yorickvP/fancontroller/hw/README.md

# Hardware revisions

## Rev 1 (10-2022)
Initial prototype production series, with several issues:
* L302 has an unusable footprint, replace with Farnell 2434098 2.5uH
* 12V is 2.5V
    * R305 -> LCSC code is for 1K
    * 16K & 1K8
* Temperature sensor is placed right next to ESP32
* Would like to toggle vfan rails individually
