yorickvP/fancontroller/hw/1/doc/powersupply-fan.pdf

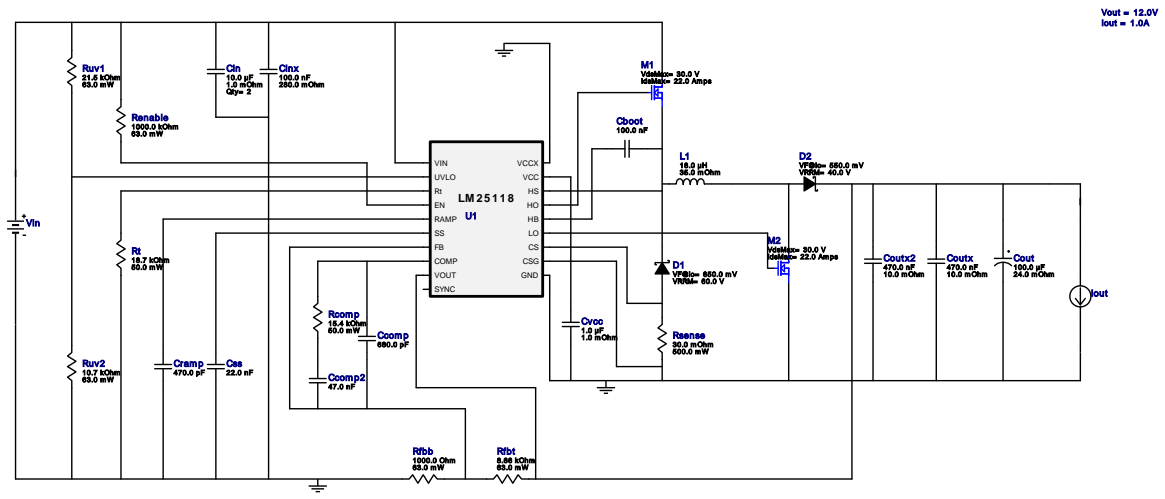
[picture p1: figure]
Cout 100.0 µF; 24.0 m Ohm; D2 VF@Io= 550.0 m V VRRM= 40.0 V; L1 18.0 µH 35.0 m Ohm; Rfbb 1000.0 Ohm 63.0 m W; Rfbt 8.66 kOhm; Vout = 12.0V Iout = 1.0A; Css; Ccom p2; Ccom p 680.0 pF; Cboot 100.0 nF; D1 VF@Io= 650.0 m V VRRM= 60.0 V; Rt 18.7 kOhm; Ruv2 10.7 kOhm 63.0 m W; Coutx 470.0 nF 10.0 m Ohm; M1 VdsMax= 30.0 V IdsMax= 22.0 Am ps; Renable 1000.0 kOhm 63.0 m W; Rsense 30.0 m Ohm 500.0 m W; VIN; UVLO; RAMP; FBCOMP; VOUT; GND; CSG; VCC; VCCX; SYNC; Rcom p 15.4 kOhm 50.0 m W; Cin 10.0 µF 1.0 m Ohm Qty= 2; Cram p 470.0 pF; Ruv1 21.5 kOhm 63.0 m W; Cinx 100.0 nF 280.0 m Ohm; M2 VdsMax= 30.0 V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

Copyright © 2022, Texas Instruments Incorporated | 1 | ti.com/webench

WEBENCH®
Design Report LM25118MH/NOPB : LM25118MH/NOPB 4.5V-20V to 12.00V @ 1A October 26, 2022 09:31:52 GMT-05:00

## WEBENCH ® Design Report

Design : 70 LM25118MH/NOPB
LM25118MH/NOPB 4.5V-20V to 12.00V @ 1A

VinMin = 4.5V
VinMax = 20.0V
Vout = 12.0V
Iout = 1.0A

Device = LM25118MH/NOPB
Topology = Buck_Boost
Created = 2022-10-26 09:30:18.954 BOM Cost = $5.30
BOM Count = 26
Total Pd = 0.43W

### Design Alerts

LM25118 Design
Tool Tip for Keep selected FETs during Redesign Configuration Option: By Default if you hit REDESIGN button, Webench re-designs all the external components including Fets. But if we have checked this configuration option, currently selected fets in schematic will get locked and redesign happens for only other external components. This helps to update the desing by keeping Fets unchanged.

## Electrical BOM

Name | Manufacturer | Part Number | Properties | Qty Price | Footprint
Cboot | AVX | 08053C104JAZ2A (http://catalogs.avx.com/SurfaceMount.pdf) Series= X7R | Cap= 100.0 nF VDC= 25.0 V IRMS= 0.0 A
1 | $0.07
| | | | | 0805 7 mm²
Ccomp | Samsung Electro- Mechanics | CL05C681JB5NNNC (http://www.samsungsem.com/servlet/FileDownload?type%3Dspec%26file%3DCL05C681JB5NNNC.pdf) Series= C0G/NP0 | Cap= 680.0 pF VDC= 50.0 V IRMS= 0.0 A
1 | $0.01
| | | | | 0402 3 mm²
Ccomp2 | Kemet | C0805C473J3GACTU (http://www.kemet.com/docfinder?Partnumber%3DC0805C473J3GACTU) Series= C0G/NP0 | Cap= 47.0 nF VDC= 25.0 V IRMS= 0.0 A
1 | $0.21
| | | | | 0805 7 mm²
Cin | TDK | C3225X7R1H106M250AC Series= X7R | Cap= 10.0 uF ESR= 1.0 mOhm VDC= 50.0 V IRMS= 5.0 A
2 | $0.27
| | | | | 1210 15 mm²
Cinx | AVX | 08053C104KAT2A (http://datasheets.avx.com/X7RDielectric.pdf) Series= X7R | Cap= 100.0 nF ESR= 280.0 mOhm VDC= 25.0 V IRMS= 0.0 A
1 | $0.01
| | | | | 0805 7 mm²
Cout | Panasonic | 25SVPF100M Series= SVPF

Cap= 100.0 uF
ESR= 24.0 mOhm
VDC= 25.0 V
IRMS= 3.2 A

1 $0.66

CAPSMT_62_E7 106 mm²
Coutx | MuRata | GRM188R71C474KA88D (http://search.murata.co.jp/Ceramy/PnsearchViewAction.do) Series= X7R

Cap= 470.0 nF
ESR= 10.0 mOhm
VDC= 16.0 V
IRMS= 0.0 A

1 $0.03
0603 5 mm²

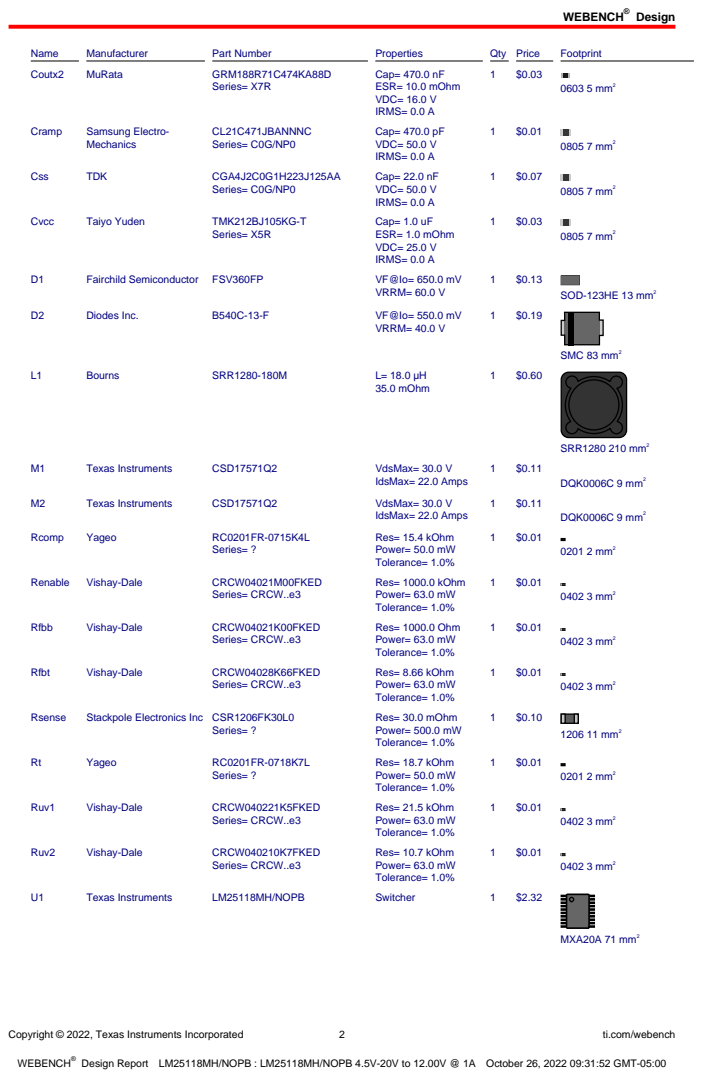
[picture p2: page 2]
Design; Copyright © 2022, Texas Instruments Incorporated; ti.com/webench; Name; Manufacturer; Part Number; Properties; Qty Price; Footprint; Coutx2; MuRata; GRM188R71C474KA88D; Series= X7R; Cap= 470.0 nF ESR= 10.0 mOhm VDC= 16.0 V IRMS= 0.0 A; 0603 5 mm²; Cramp; Samsung Electro-; Mechanics; CL21C471JBANNNC Series= C0G/NP0; Cap= 470.0 pF VDC= 50.0 V IRMS= 0.0 A; 0805 7 mm²; Css; TDK; CGA4J2C0G1H223J125AA; Series= C0G/NP0; Cap= 22.0 nF VDC= 50.0 V IRMS= 0.0 A; Cvcc; Taiyo Yuden; TMK212BJ105KG-T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

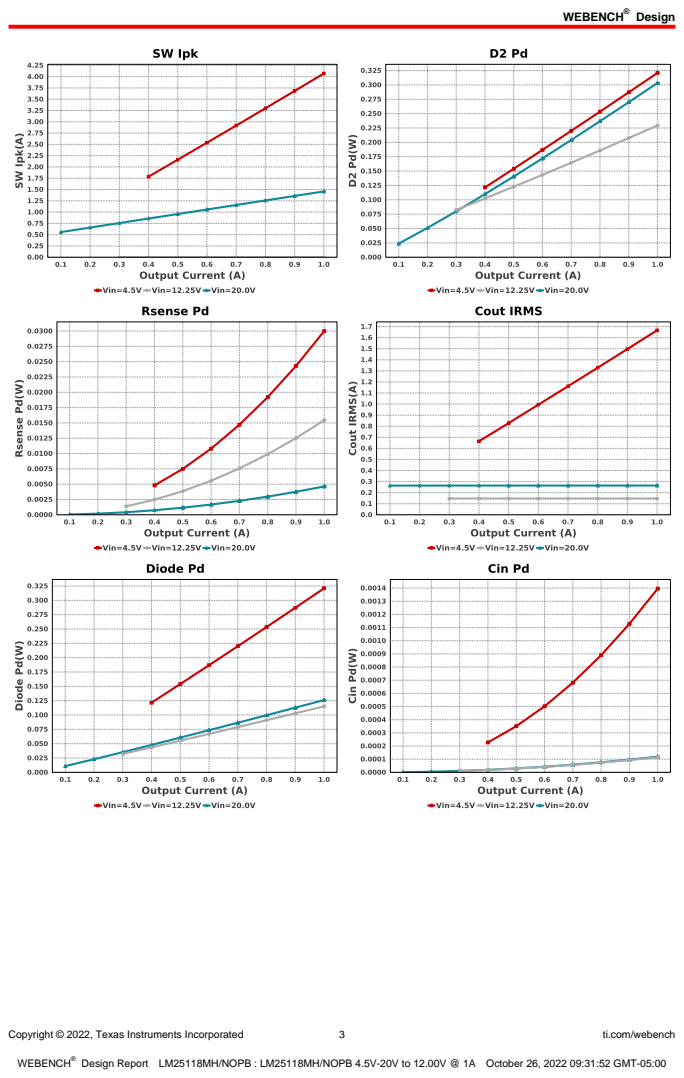
[picture p3: page 3]
Copyright © 2022, Texas Instruments Incorporated; ti.com/webench

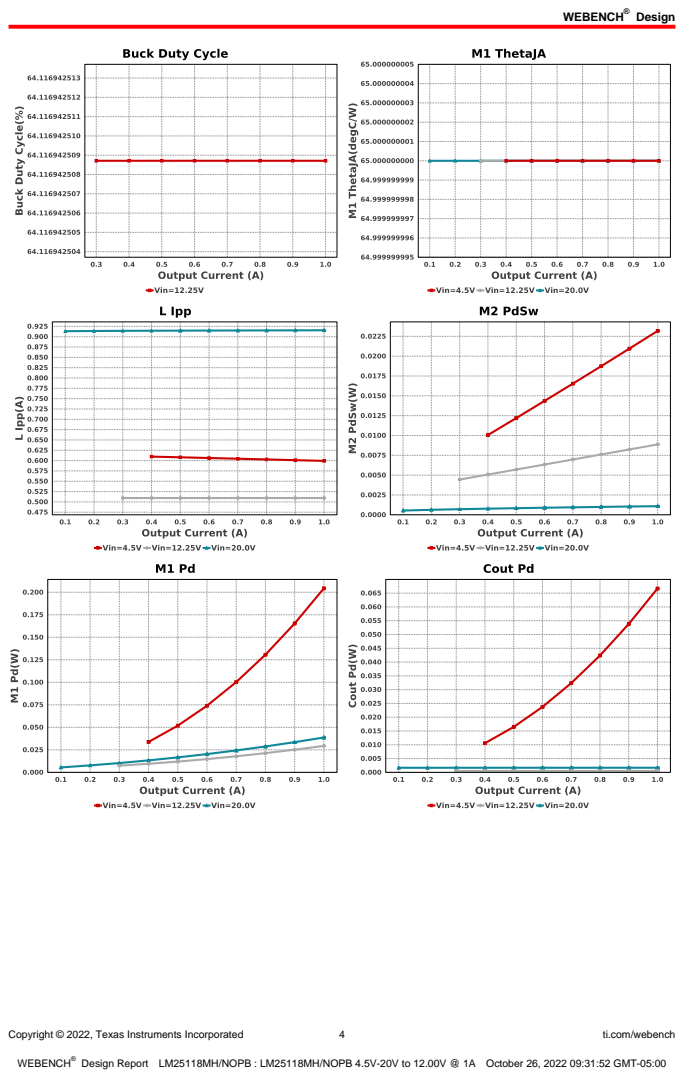
[picture p4: page 4]
Copyright © 2022, Texas Instruments Incorporated; ti.com/webench

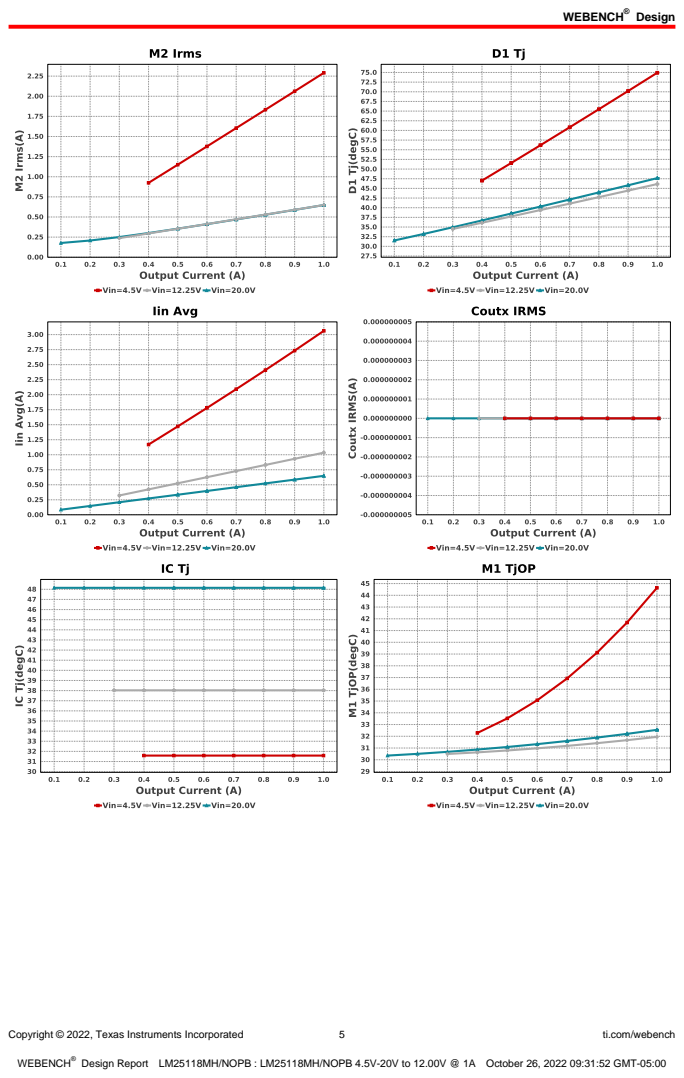
[picture p5: page 5]
Copyright © 2022, Texas Instruments Incorporated; ti.com/webench

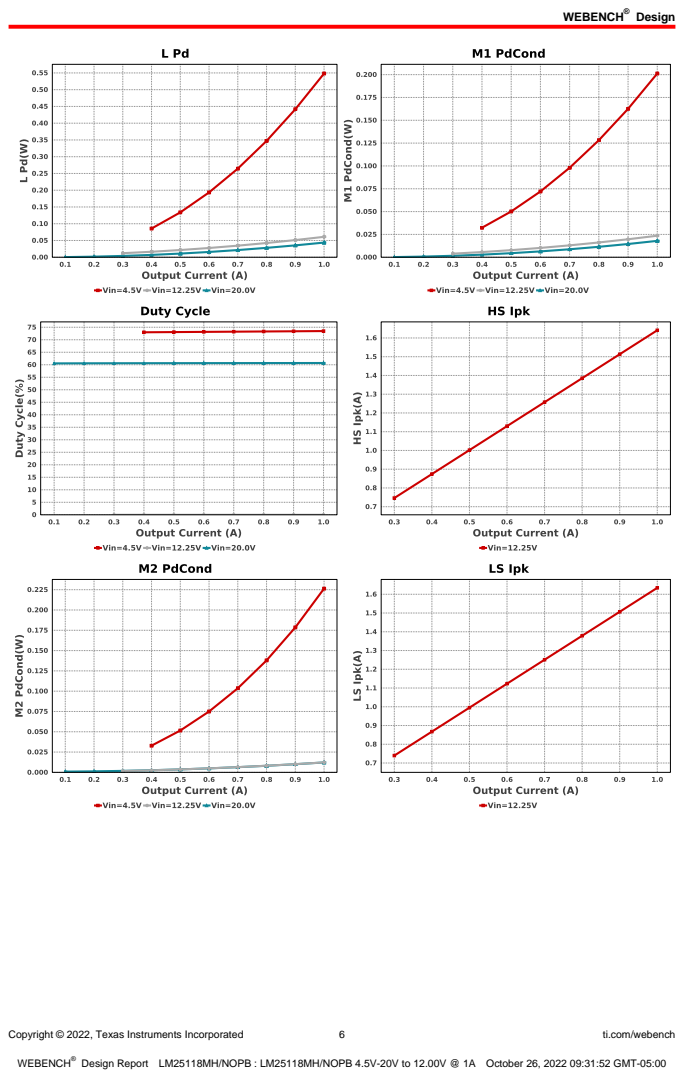
[picture p6: page 6]
Copyright © 2022, Texas Instruments Incorporated; ti.com/webench

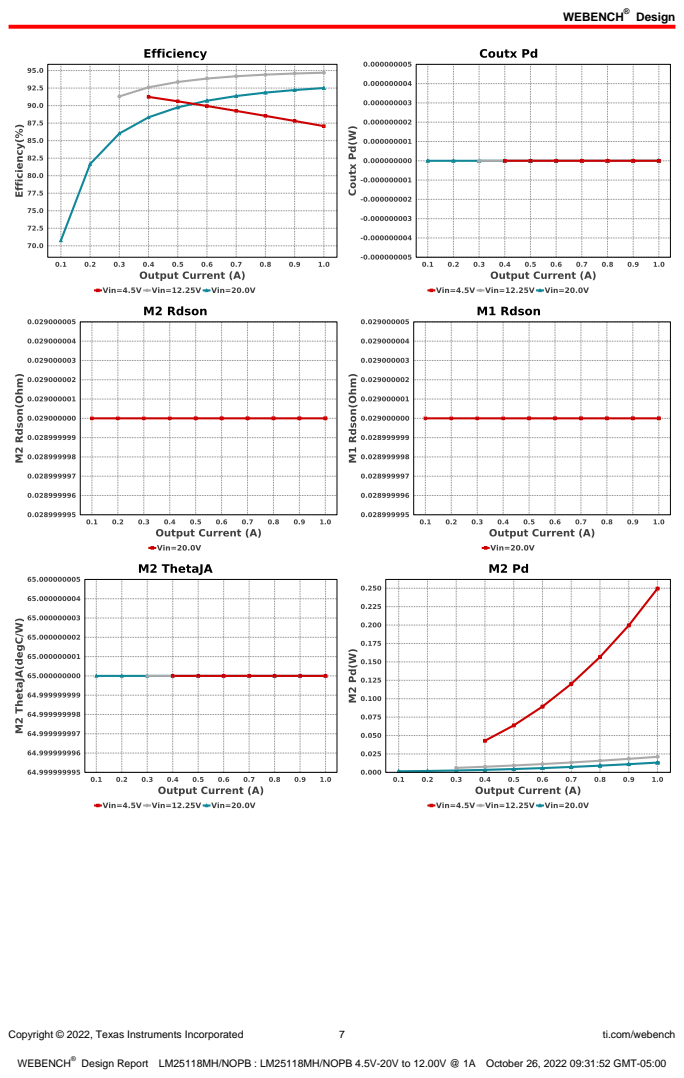
[picture p7: page 7]
Copyright © 2022, Texas Instruments Incorporated; ti.com/webench

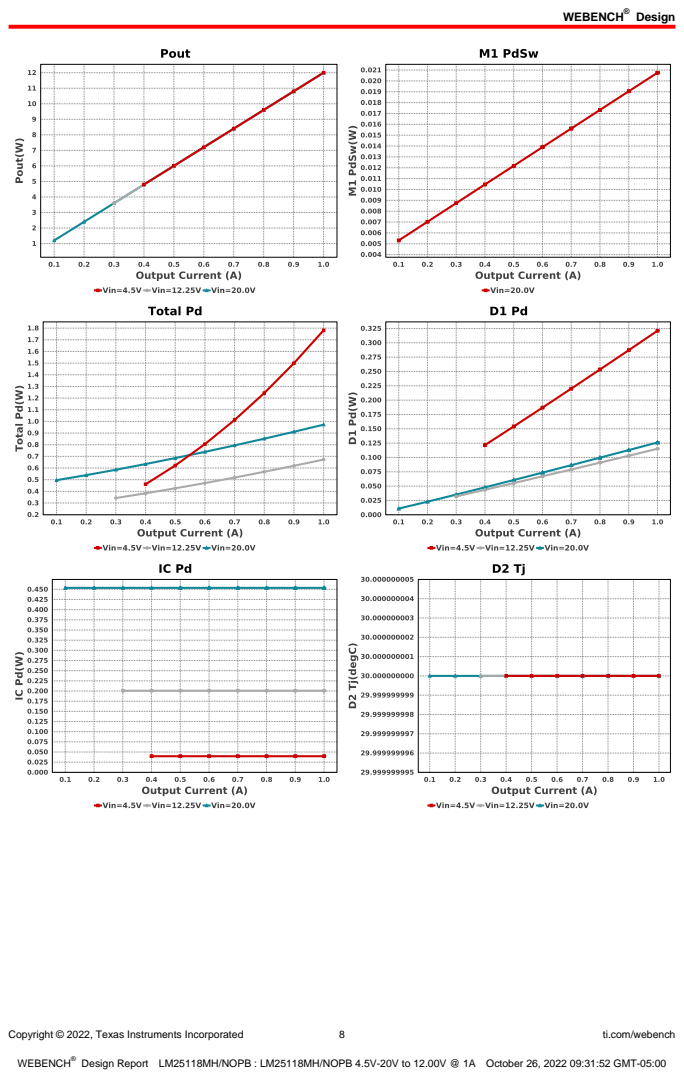
[picture p8: page 8]
Copyright © 2022, Texas Instruments Incorporated; ti.com/webench

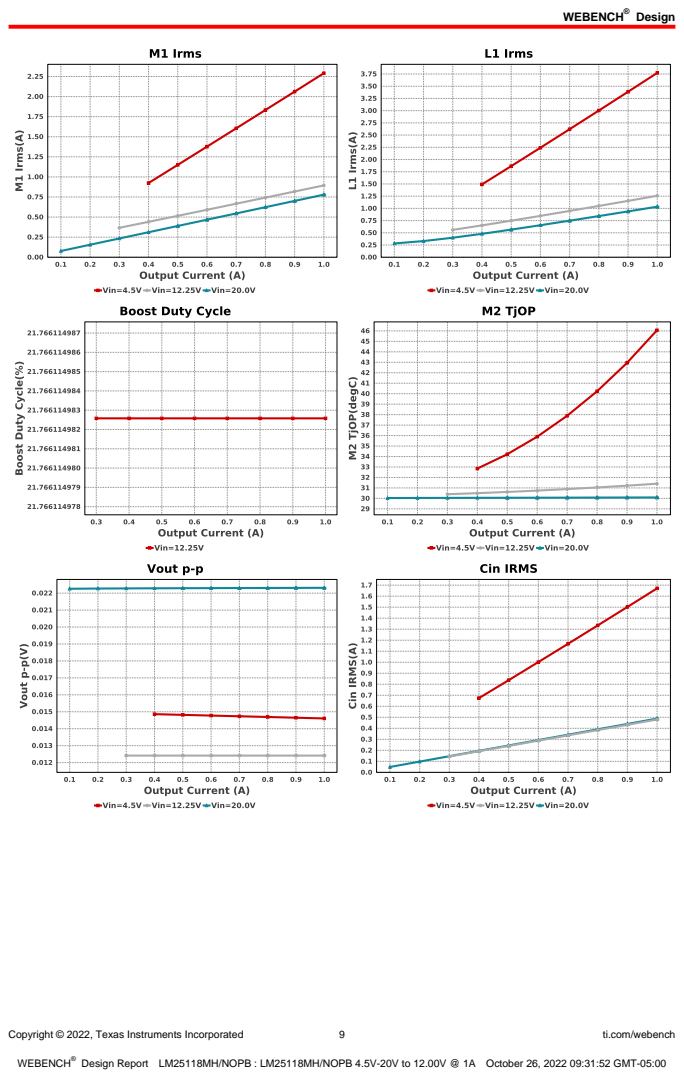
[picture p9: page 9]
Copyright © 2022, Texas Instruments Incorporated; ti.com/webench

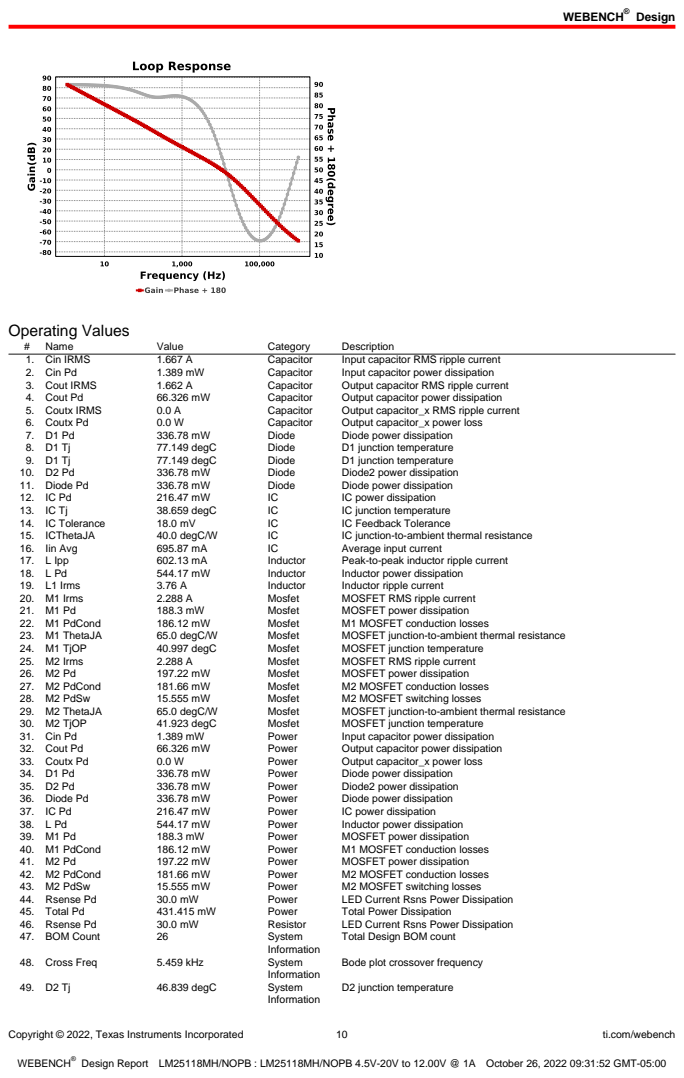
[picture p10: page 10]
Copyright © 2022, Texas Instruments Incorporated; ti.com/webench; Operating Values; Name; Value; Category; Description; 1. Cin IRMS; Capacitor; Input capacitor RMS ripple current; 2. Cin Pd; Input capacitor power dissipation; 3. Cout IRMS; Output capacitor RMS ripple current; 4. Cout Pd; Output capacitor power dissipation; 5. Coutx IRMS; Output capacitor_x RMS ripple current; 6. Coutx Pd; Output capacitor_x power loss; Diode; Diode power dissipation; 77.149 degC; D1 junction temperature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

Total Design BOM count

Bode plot crossover frequency

Copyright © 2022, Texas Instruments Incorporated | 11 | ti.com/webench
# | Name | Value | Category | Description

50. Duty Cycle | 73.373 % | System
| | | Information | Duty cycle
51. Efficiency | 86.223 % | System
| | | Information | Steady state efficiency
52. FootPrint | 615.0 mm² | System
| | | Information | Total Foot Print Area of BOM components
53. Frequency | 294.659 kHz | System
| | | Information | Switching frequency
54. Gain Marg | -27.135 dB | System
| | | Information | Bode Plot Gain Margin
55. Iout | 1.0 A | System
| | | Information | Iout operating point
56. Low Freq Gain | 76.114 dB | System
| | | Information | Gain at 1Hz
57. Mode | CCM | System
| | | Information | Conduction Mode
58. Operating Topology | Buck-Boost | System
| | | Information | The current operating topology of the device
59. Phase Marg | 67.721 deg | System
| | | Information | Bode Plot Phase Margin
60. Pout | 12.0 W | System
| | | Information | Total output power
61. SW Ipk | 4.057 A | System
| | | Information | Peak switch current
62. Total BOM | $5.3 | System
| | | Information | Total BOM Cost
63. Vin | 4.5 V | System
| | | Information | Vin operating point
64. Vout | 12.0 V | System
| | | Information | Operational Output Voltage
65. Vout Actual | 11.882 V | System
| | | Information | Vout Actual calculated based on selected voltage divider resistors
66. Vout Tolerance | 3.301 % | System
| | | Information | Vout Tolerance based on IC Tolerance (no load) and voltage divider resistors if applicable
67. Vout p-p | 14.675 mV | System
| | | Information | Peak-to-peak output ripple voltage

## Design Inputs

Name | Value | Description
Iout | 1.0 | Maximum Output Current
VinMax | 20.0 | Maximum input voltage
VinMin | 4.5 | Minimum input voltage
Vout | 12.0 | Output Voltage
| base_pn | | LM25118 | Base Product Number
source | DC | Input Source Type
Ta | 30.0 | Ambient temperature


Copyright © 2022, Texas Instruments Incorporated | 12 | ti.com/webench

## Assembly

## Component Testing

Some published data on components in datasheets such as Capacitor ESR and Inductor DC resistance is based on conservative values that will guarantee that the components always exceed the specification. For design purposes it is usually better to work with typical values. Since this data is not always available it is a good practice to measure the Capacitance and ESR values of Cin and Cout, and the inductance and DC resistance of L1 before assembly of the board. Any large discrepancies in values should be electrically simulated in WEBENCH to check for instabilities and thermally simulated in WebTHERM to make sure critical temperatures are not exceeded.

## Soldering Component to Board

If board assembly is done in house it is best to tack down one terminal of a component on the board then solder the other terminal. For surface mount parts with large tabs, such as the DPAK, the tab on the back of the package should be pre-tinned with solder, then tacked into place by one of the pins. To solder the tab town to the board place the iron down on the board while resting against the tab, heating both surfaces simultaneously. Apply light pressure to the top of the plastic case until the solder flows around the part and the part is flush with the PCB. If the solder is not flowing around the board you may need a higher wattage iron (generally 25W to 30W is enough).

## Initial Startup of Circuit

It is best to initially power up the board by setting the input supply voltage to the lowest operating input voltage 4.5V and set the input supply's current limit to zero. With the input supply off connect up the input supply to Vin and GND. Connect a digital volt meter and a load if needed to set the minimum Iout of the design from Vout and GND. Turn on the input supply and slowly turn up the current limit on the input supply. If the voltage starts to rise on the input supply continue increasing the input supply current limit while watching the output voltage. If the current increases on the input supply, but the voltage remains near zero, then there may be a short or a component misplaced on the board. Power down the board and visually inspect for solder bridges and recheck the diode and capacitor polarities. Once the power supply circuit is operational then more extensive testing may include full load testing, transient load and line tests to compare with simulation results.

## Load Testing

The setup is the same as the initial startup, except that an additional digital voltmeter is connected between Vin and GND, a load is connected between Vout and GND and a current meter is connected in series between Vout and the load. The load must be able to handle at least rated output power + 50% ( 7.5 watts for this design). Ideally the load is supplied in the form of a variable load test unit. It can also be done in the form of suitably large power resistors. When using an oscilloscope to measure waveforms on the prototype board, the ground leads of the oscilloscope probes should be as short as possible and the area of the loop formed by the ground lead should be kept to a minimum. This will help reduce ground lead inductance and eliminate EMI noise that is not actually present in the circuit.

## Design Assistance

1. The LM25118 is a wide range buck-boost controller which is operable in an ultra wide input range of 3 to 75V. A buck-boost regulator can maintain regulation for input voltages either higher or lower than the output voltage. The challenge is that buck-boost power converters are not as efficient as buck regulators. The LM5118 has been designed as a dual mode controller whereby the power converter acts as a buck regulator while the input voltage is above the output. As the input voltage approaches the output voltage, a gradual transition to the buck-boost mode occurs. This gradual transition between modes eliminates disturbances at the output during transitions.
2. Master key : 7E00AF9B0638DEC2[v1]
3. LM25118 Product Folder : http://www.ti.com/product/LM25118 : contains the data sheet and other resources.

Copyright © 2022, Texas Instruments Incorporated | 13 | ti.com/webench

Important Notice and Disclaimer

TI provides technical and reliability data (including datasheets), design resources (including reference designs), application or other design advice, web tools, safety information, and other resources AS IS and with all faults, and disclaims all warranties. These resources are intended for skilled developers designing with TI products. You are solely responsible for (1) selecting the appropriate TI products for your application, (2) designing, validating and testing your application, and (3) ensuring your application meets applicable standards, and any other safety, security, or other requirements.

These resources are subject to change without notice. TI grants you permission to use these resources only for development of an application that uses the TI products described in the resource. Other reproduction and display of these resources is prohibited. No license is granted to any other TI intellectual property right or to any third party intellectual property right. TI disclaims responsibility for, and you will fully indemnify TI and its representatives against, any claims, damages, costs, losses, and liabilities arising out of your use of these resources.

Providing these resources does not expand or otherwise alter TI's applicable Terms of Sale or other applicable terms available either on ti.com or provided in conjunction with TI products.
