yorickvP/fancontroller/hw/1/sensor/fancontroller-sensor.kicad_pcb

## KiCad design hw/1/sensor/fancontroller-sensor.kicad_pcb (2023-11-10)

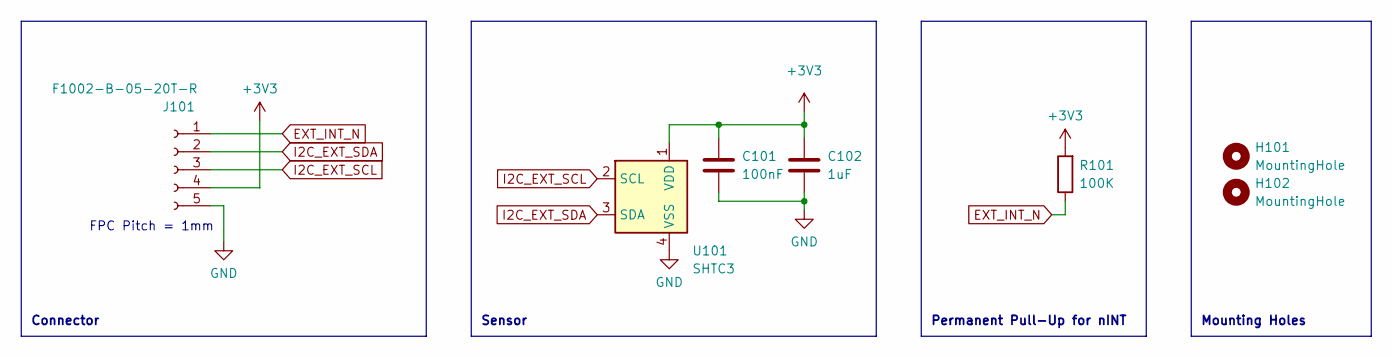
[picture p17: schematic fancontroller-sensor.kicad_sch]

Parts:
C101: 100nF; C_0402_1005Metric; LCSC C307331
C102: 1uF; C_0402_1005Metric; LCSC C52923
H101, H102: MountingHole; MountingHole_2.2mm_M2
J101: F1002-B-05-20T-R; LCSC C3015089
R101: 100K; R_0402_1005Metric; LCSC C25741
U101: SHTC3; Sensirion_DFN-4-1EP_2x2mm_P1mm_EP0.7x1.6mm

Connections:
+3V3: C101.1, C102.1, J101.4, R101.2, U101.1 (VDD)
EXT_INT_N: J101.1, R101.1
GND: C101.2, C102.2, J101.5, U101.4 (VSS)
I2C_EXT_SCL: J101.3, U101.2 (SCL)
I2C_EXT_SDA: J101.2, U101.3 (SDA)

Notes on the sheet:
Mounting Holes
Connector
Sensor
FPC Pitch = 1mm
Permanent Pull-Up for nINT

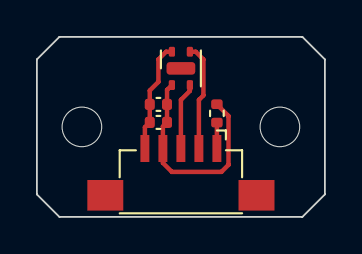
[picture p18: board fancontroller-sensor.kicad_pcb from above]

Board: 2 copper layers, 16.0 x 10.0 mm, 7 parts (0 on the bottom side), 5 nets.
