yorickvP/fancontroller/hw/1/fancontroller.kicad_pcb

## KiCad design hw/1/fancontroller.kicad_pcb (2023-11-10)

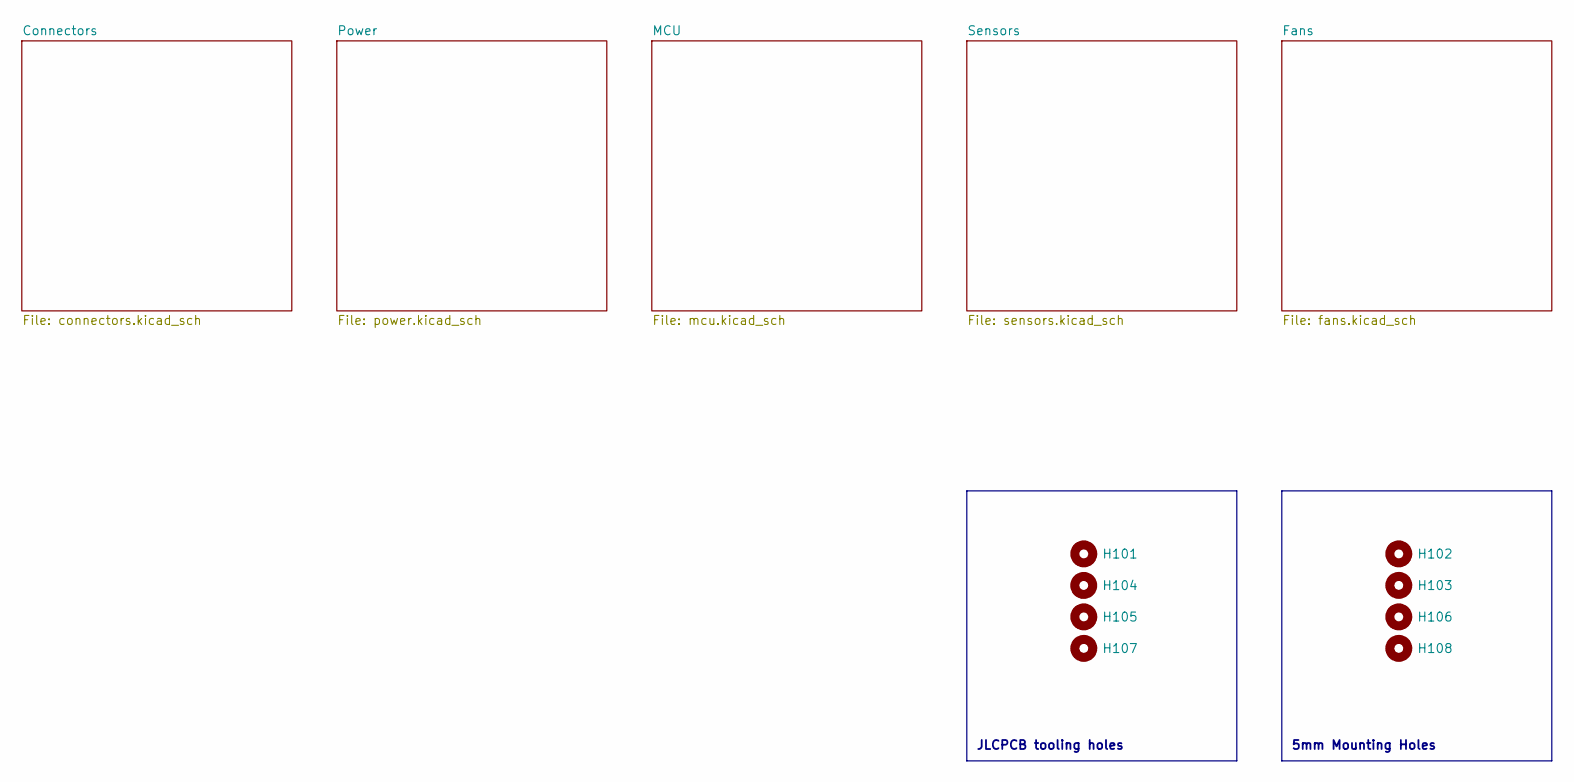
[picture p19: schematic fancontroller.kicad_sch]

Parts:
H101, H104, H105, H107: ToolingHole; JLCPCB tooling hole
H102, H103, H106, H108: MountingHole; MountingHole_5mm_Keepout

Notes on the sheet:
JLCPCB tooling holes
5mm Mounting Holes

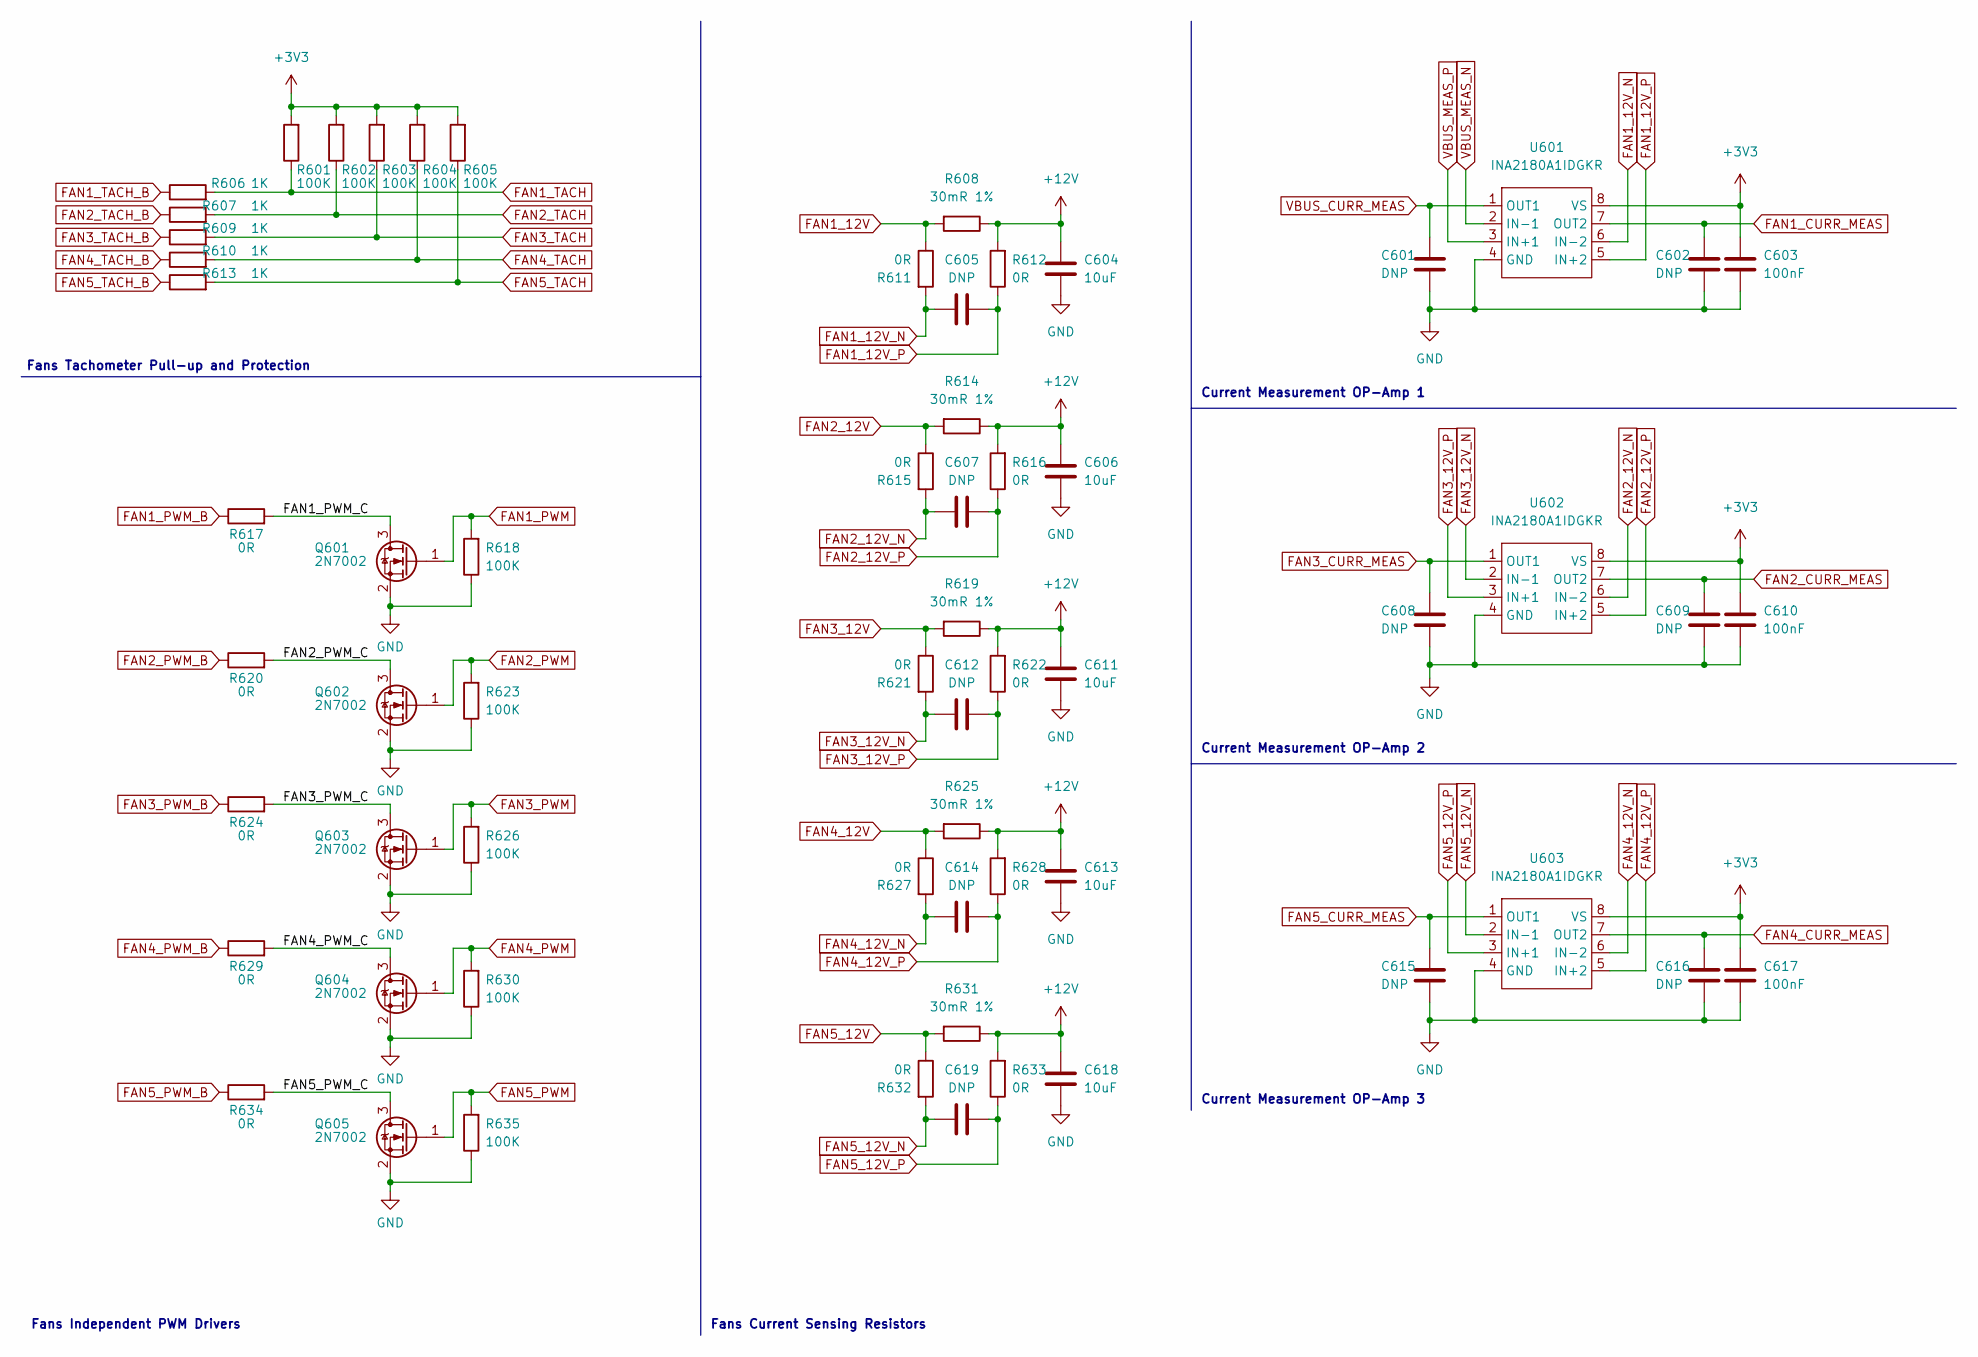
[picture p20: schematic fans.kicad_sch]

Parts:
C601, C602, C605, C607, C608, C609, C612, C614, C615, C616, C619: DNP; C_0402_1005Metric
C603, C610, C617: 100nF; C_0402_1005Metric; LCSC C307331
C604, C606, C611, C613, C618: 10uF; C_0805_2012Metric; LCSC C15850
Q601, Q602, Q603, Q604, Q605: 2N7002; SOT-23; LCSC C8545
R601, R602, R603, R604, R605, R618, R623, R626, R630, R635: 100K; R_0402_1005Metric; LCSC C25741
R606, R607, R609, R610, R613: 1K; R_0402_1005Metric; LCSC C11702
R608, R614, R619, R625, R631: 30mR 1%; R_0805_2012Metric; LCSC C247605
R611, R612, R615, R616, R617, R620, R621, R622, R624, R627, R628, R629, R632, R633, R634: 0R; R_0402_1005Metric; LCSC C17168
U601, U602, U603: INA2180A1IDGKR; VSSOP-8_3.0x3.0mm_P0.65mm; LCSC C2058454

Connections:
+3V3: C603.1, C610.1, C617.1, R601.2, R602.2, R603.2, R604.2, R605.2, U601.8 (VS), U602.8 (VS), U603.8 (VS); also elsewhere on the board
+12V: C604.1, C606.1, C611.1, C613.1, C618.1, R608.1, R612.2, R614.1, R616.2, R619.1, R622.2, R625.1, R628.2, R631.1, R633.2; also elsewhere on the board
/Fans/FAN1_PWM_C: Q601.3 (D), R617.2
/Fans/FAN2_PWM_C: Q602.3 (D), R620.2
/Fans/FAN3_PWM_C: Q603.3 (D), R624.2
/Fans/FAN4_PWM_C: Q604.3 (D), R629.2
/Fans/FAN5_PWM_C: Q605.3 (D), R634.2
FAN1_12V: R608.2, R611.1; also elsewhere on the board
FAN1_12V_N: C605.1, R611.2, U601.6 (IN-2)
FAN1_12V_P: C605.2, R612.1, U601.5 (IN+2)
FAN1_CURR_MEAS: C602.1, U601.7 (OUT2); also elsewhere on the board
FAN1_PWM: Q601.1 (G), R618.2; also elsewhere on the board
FAN1_PWM_B: R617.1; also elsewhere on the board
FAN1_TACH: R601.1, R606.2; also elsewhere on the board
FAN1_TACH_B: R606.1; also elsewhere on the board
FAN2_12V: R614.2, R615.1; also elsewhere on the board
FAN2_12V_N: C607.1, R615.2, U602.6 (IN-2)
FAN2_12V_P: C607.2, R616.1, U602.5 (IN+2)
FAN2_CURR_MEAS: C609.1, U602.7 (OUT2); also elsewhere on the board
FAN2_PWM: Q602.1 (G), R623.2; also elsewhere on the board
FAN2_PWM_B: R620.1; also elsewhere on the board
FAN2_TACH: R602.1, R607.2; also elsewhere on the board
FAN2_TACH_B: R607.1; also elsewhere on the board
FAN3_12V: R619.2, R621.1; also elsewhere on the board
FAN3_12V_N: C612.1, R621.2, U602.2 (IN-1)
FAN3_12V_P: C612.2, R622.1, U602.3 (IN+1)
FAN3_CURR_MEAS: C608.1, U602.1 (OUT1); also elsewhere on the board
FAN3_PWM: Q603.1 (G), R626.2; also elsewhere on the board
FAN3_PWM_B: R624.1; also elsewhere on the board
FAN3_TACH: R603.1, R609.2; also elsewhere on the board
FAN3_TACH_B: R609.1; also elsewhere on the board
FAN4_12V: R625.2, R627.1; also elsewhere on the board
FAN4_12V_N: C614.1, R627.2, U603.6 (IN-2)
FAN4_12V_P: C614.2, R628.1, U603.5 (IN+2)
FAN4_CURR_MEAS: C616.1, U603.7 (OUT2); also elsewhere on the board
FAN4_PWM: Q604.1 (G), R630.2; also elsewhere on the board
FAN4_PWM_B: R629.1; also elsewhere on the board
FAN4_TACH: R604.1, R610.2; also elsewhere on the board
FAN4_TACH_B: R610.1; also elsewhere on the board
FAN5_12V: R631.2, R632.1; also elsewhere on the board
FAN5_12V_N: C619.1, R632.2, U603.2 (IN-1)
FAN5_12V_P: C619.2, R633.1, U603.3 (IN+1)
FAN5_CURR_MEAS: C615.1, U603.1 (OUT1); also elsewhere on the board
FAN5_PWM: Q605.1 (G), R635.2; also elsewhere on the board
FAN5_PWM_B: R634.1; also elsewhere on the board
FAN5_TACH: R605.1, R613.2; also elsewhere on the board
FAN5_TACH_B: R613.1; also elsewhere on the board
VBUS_CURR_MEAS: C601.1, U601.1 (OUT1); also elsewhere on the board
VBUS_MEAS_N: U601.2 (IN-1); also elsewhere on the board
VBUS_MEAS_P: U601.3 (IN+1); also elsewhere on the board

Notes on the sheet:
Current Measurement OP-Amp 3
Fans Independent PWM Drivers
Current Measurement OP-Amp 1
Fans Current Sensing Resistors
Fans Tachometer Pull-up and Protection
Current Measurement OP-Amp 2

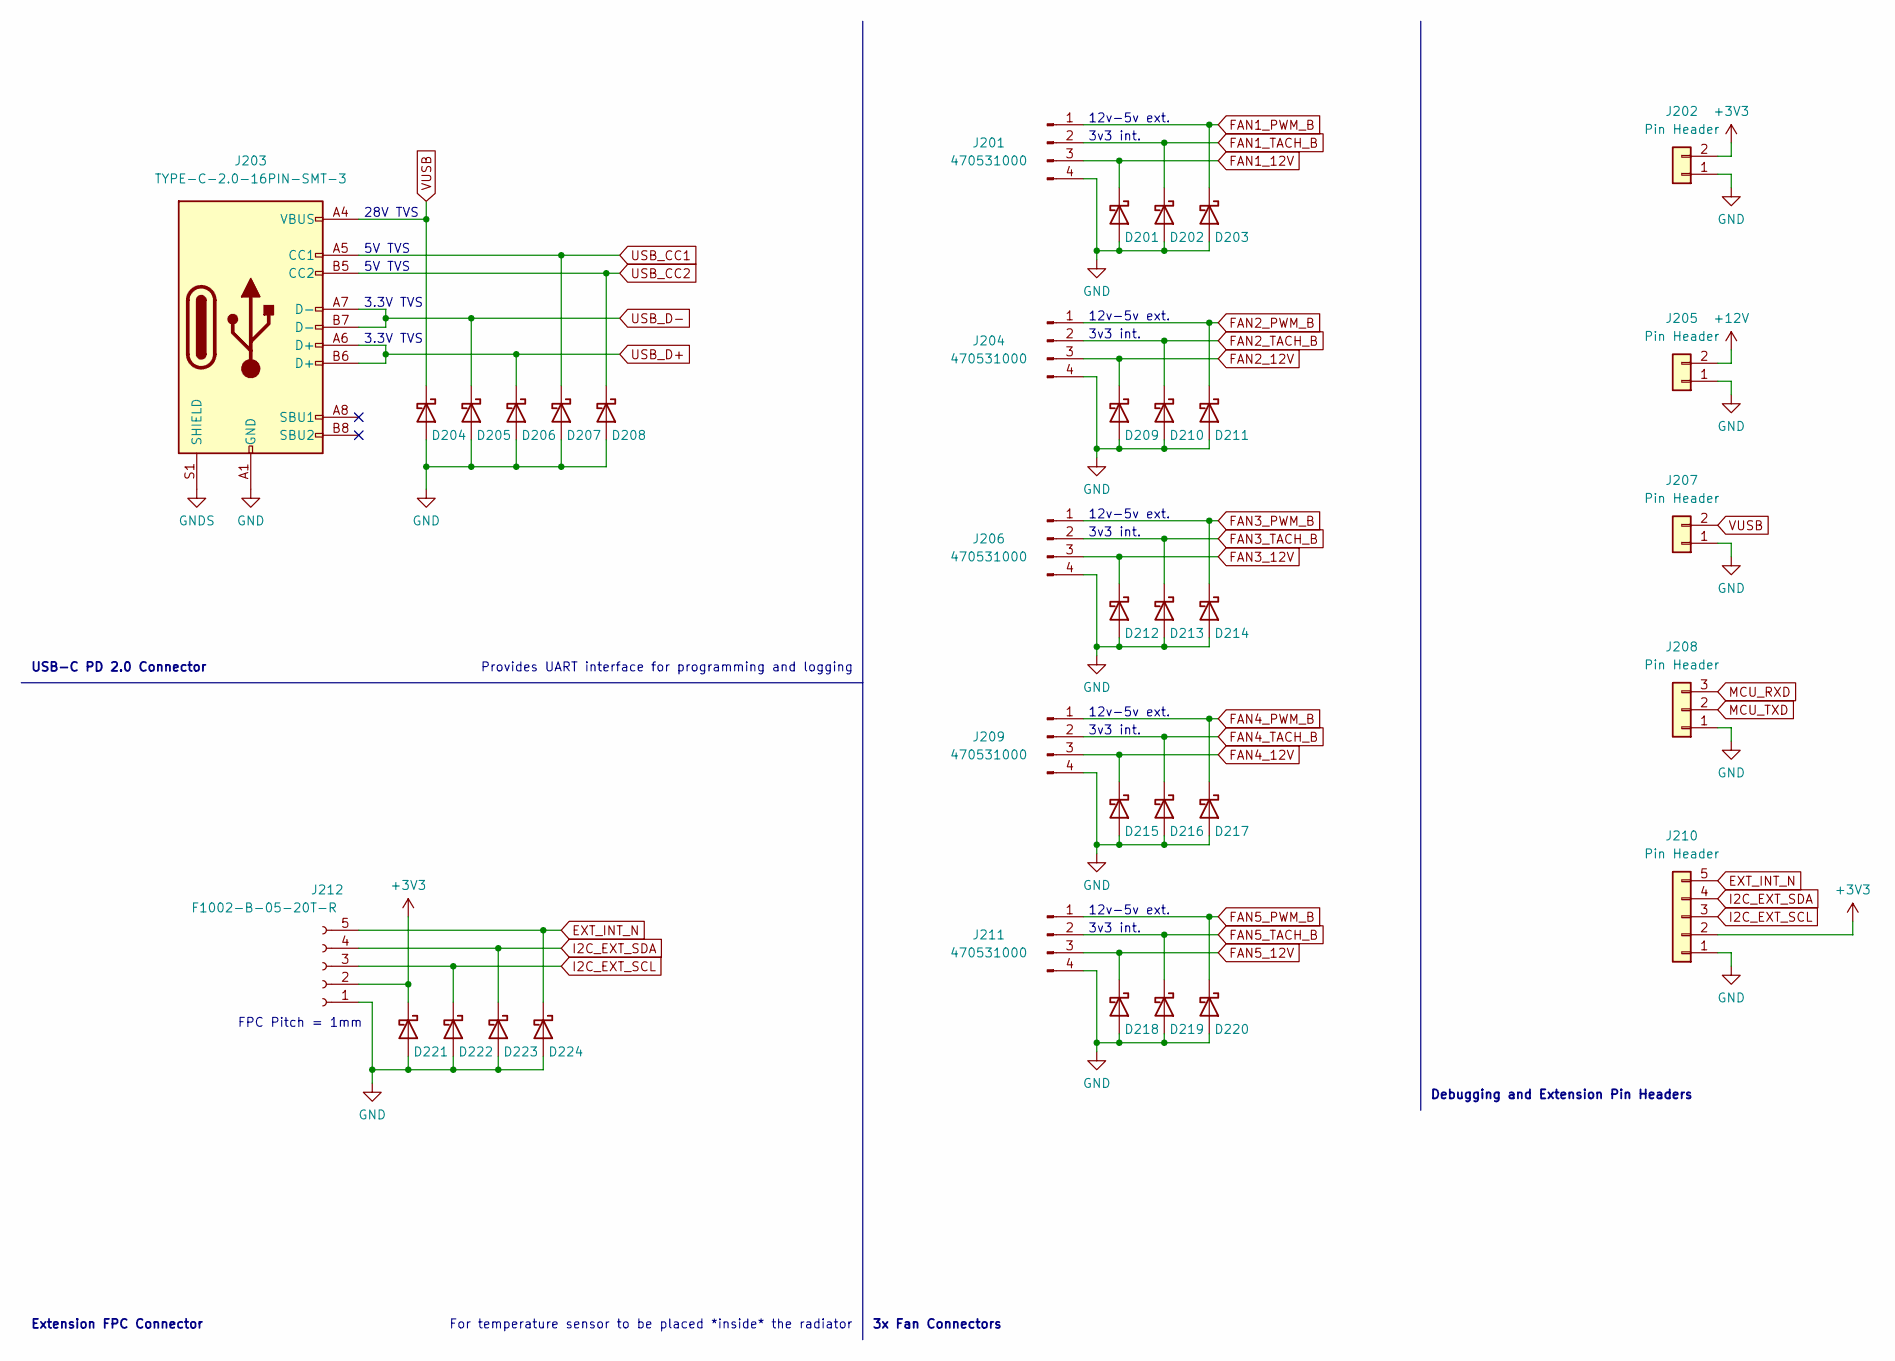
[picture p21: schematic connectors.kicad_sch]

Parts:
D201, D203, D209, D211, D212, D214, D215, D217, D218, D220: AQ4022-01FTG; D_SOD-323; LCSC C468894
D202, D205, D206, D210, D213, D216, D219, D221, D222, D223, D224: ESD9L3.3ST5G; D_SOD-923; LCSC C233387
D204: SJD12A28L01; D_SOD-123S; LCSC C313190
D207, D208: ESD9X5.0ST5G; D_SOD-923; LCSC C87910
J201, J204, J206, J209, J211: 470531000; Molex_470531000_PWM_fan; LCSC C240840
J202, J205, J207: Pin Header; PinHeader_1x02_P2.54mm_Vertical
J203: TYPE-C-2.0-16PIN-SMT-3; LCSC C2987386
J208: Pin Header; PinHeader_1x03_P2.54mm_Vertical
J210: Pin Header; PinHeader_1x05_P2.54mm_Vertical
J212: F1002-B-05-20T-R; LCSC C3015089

Connections:
+3V3: D221.1 (K), J202.2, J210.2, J212.2; also elsewhere on the board
+12V: J205.2; also elsewhere on the board
EXT_INT_N: D224.1 (K), J210.5, J212.5; also elsewhere on the board
FAN1_12V: D201.1 (K), J201.3; also elsewhere on the board
FAN1_PWM_B: D203.1 (K), J201.1; also elsewhere on the board
FAN1_TACH_B: D202.1 (K), J201.2; also elsewhere on the board
FAN2_12V: D209.1 (K), J204.3; also elsewhere on the board
FAN2_PWM_B: D211.1 (K), J204.1; also elsewhere on the board
FAN2_TACH_B: D210.1 (K), J204.2; also elsewhere on the board
FAN3_12V: D212.1 (K), J206.3; also elsewhere on the board
FAN3_PWM_B: D214.1 (K), J206.1; also elsewhere on the board
FAN3_TACH_B: D213.1 (K), J206.2; also elsewhere on the board
FAN4_12V: D215.1 (K), J209.3; also elsewhere on the board
FAN4_PWM_B: D217.1 (K), J209.1; also elsewhere on the board
FAN4_TACH_B: D216.1 (K), J209.2; also elsewhere on the board
FAN5_12V: D218.1 (K), J211.3; also elsewhere on the board
FAN5_PWM_B: D220.1 (K), J211.1; also elsewhere on the board
FAN5_TACH_B: D219.1 (K), J211.2; also elsewhere on the board
GNDS: J203.S1 (SHIELD)
I2C_EXT_SCL: D222.1 (K), J210.3, J212.3; also elsewhere on the board
I2C_EXT_SDA: D223.1 (K), J210.4, J212.4; also elsewhere on the board
MCU_RXD: J208.3; also elsewhere on the board
MCU_TXD: J208.2; also elsewhere on the board
USB_CC1: D207.1 (K), J203.A5 (CC1); also elsewhere on the board
USB_CC2: D208.1 (K), J203.B5 (CC2); also elsewhere on the board
USB_D+: D206.1 (K), J203.A6 (D+), J203.B6 (D+); also elsewhere on the board
USB_D-: D205.1 (K), J203.A7 (D-), J203.B7 (D-); also elsewhere on the board
VUSB: D204.1 (K), J203.A4 (VBUS), J203.A9 (VBUS), J203.B4 (VBUS), J203.B9 (VBUS), J207.2; also elsewhere on the board

Notes on the sheet:
Debugging and Extension Pin Headers
12v-5v ext.
5V TVS
3.3V TVS
FPC Pitch = 1mm
Provides UART interface for programming and logging
28V TVS
For temperature sensor to be placed *inside* the radiator
3x Fan Connectors
3v3 int.
USB-C PD 2.0 Connector
Extension FPC Connector

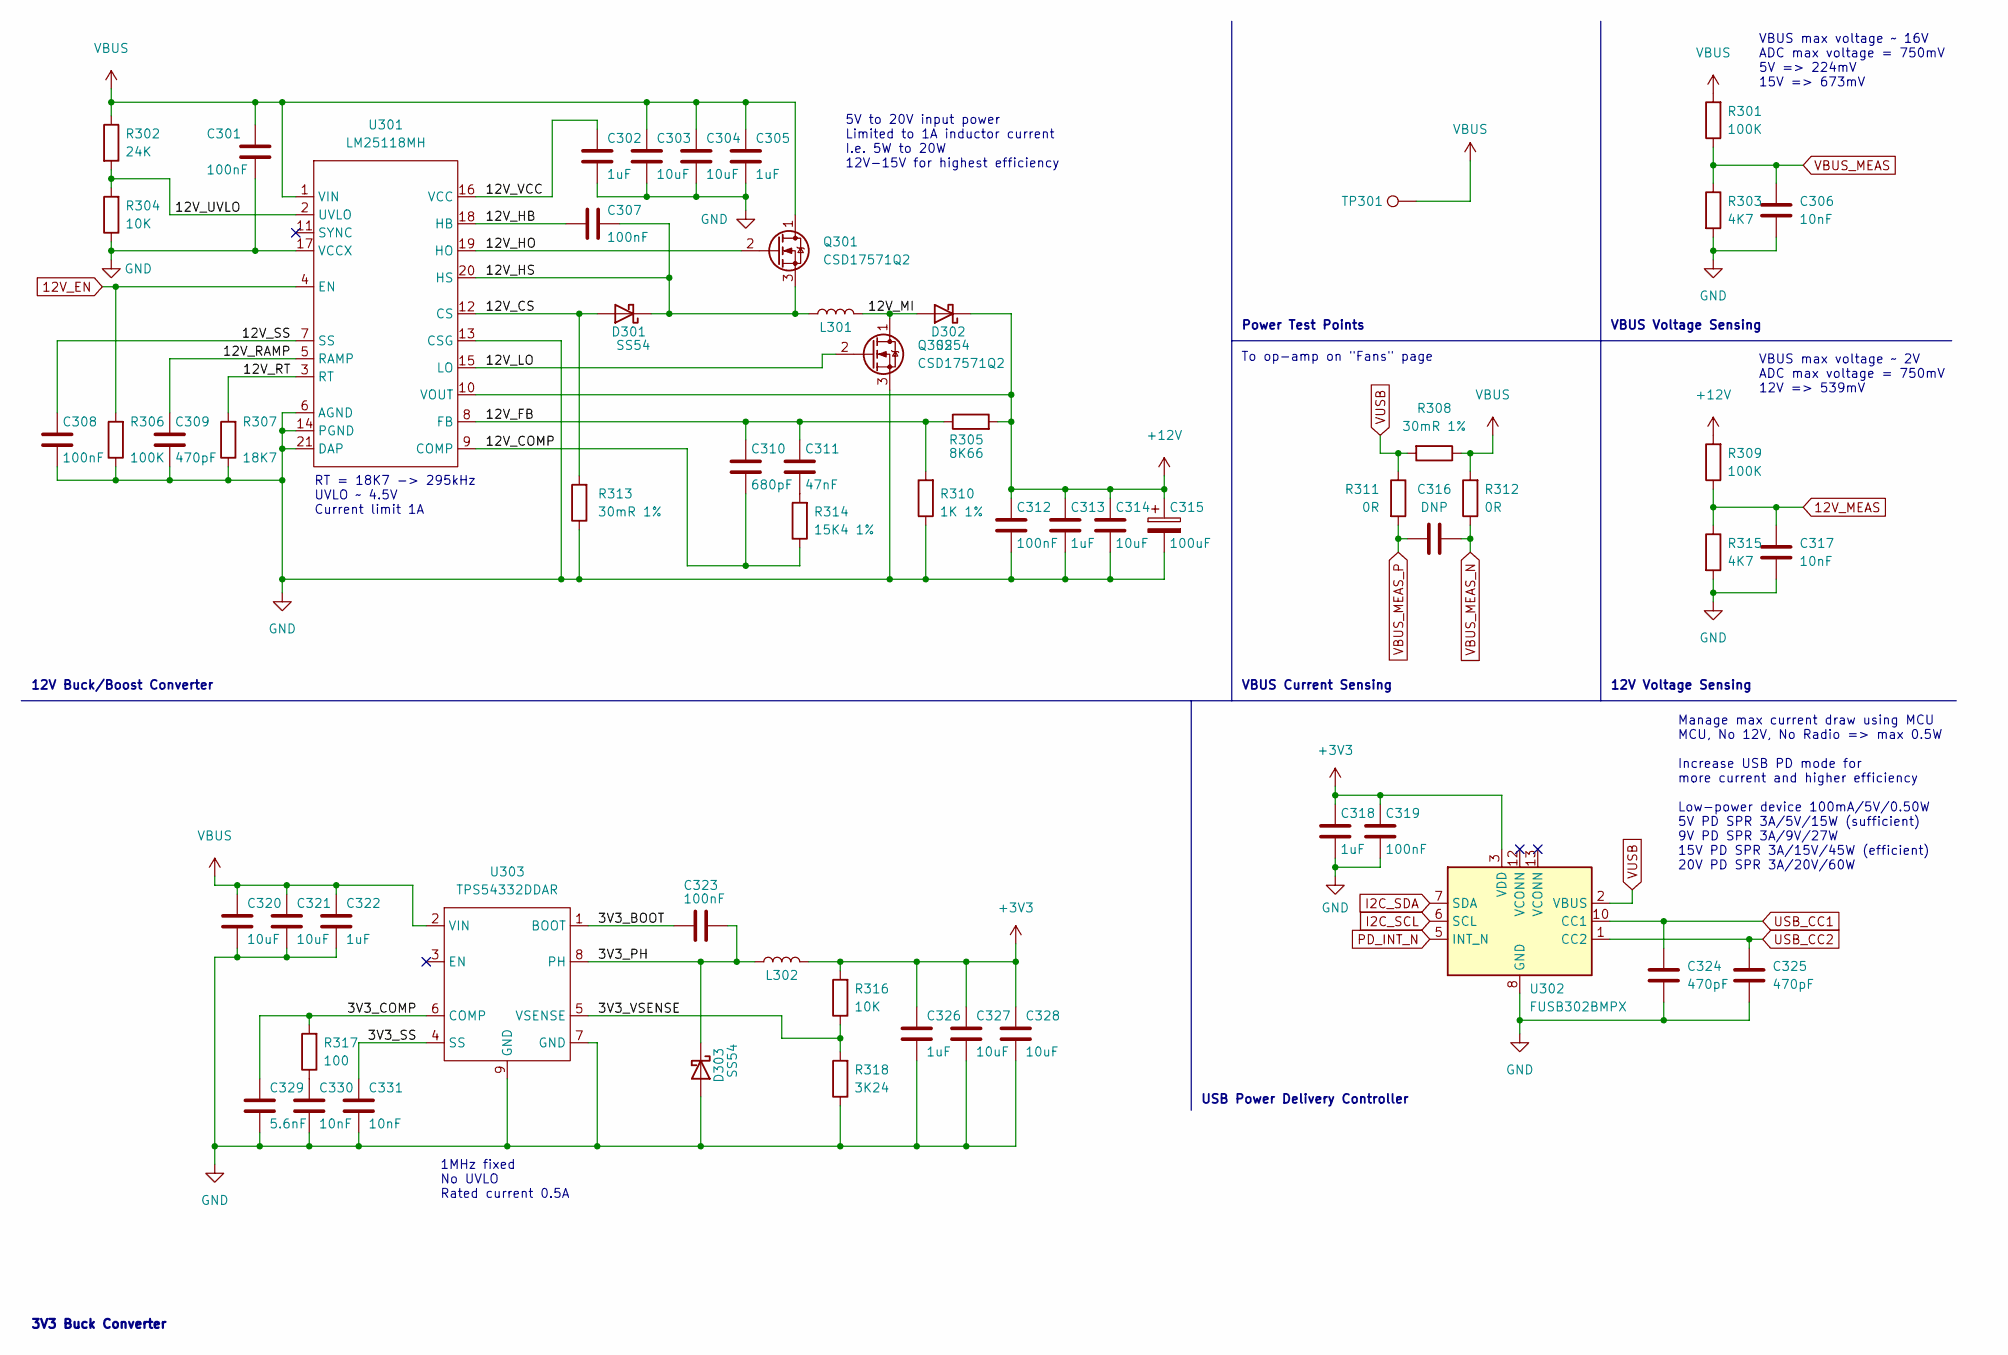
[picture p22: schematic power.kicad_sch]

Parts:
C301, C307, C308, C312, C319, C323: 100nF; C_0402_1005Metric; LCSC C307331
C302, C305, C313, C318, C322, C326: 1uF; C_0402_1005Metric; LCSC C52923
C303, C304, C314, C320, C321, C327, C328: 10uF; C_0805_2012Metric; LCSC C15850
C306, C317, C330, C331: 10nF; C_0402_1005Metric; LCSC C15195
C309, C324, C325: 470pF; C_0402_1005Metric; LCSC C1537
C310: 680pF; C_0402_1005Metric; LCSC C338094
C311: 47nF; C_0402_1005Metric; LCSC C368599
C315: 100uF; CP_Elec_6.3x7.7; LCSC C3339
C316: DNP; C_0402_1005Metric
C329: 5.6nF; C_0402_1005Metric; LCSC C115688
D301, D302, D303: SS54; D_SMA; LCSC C22452
L301: CDRH127NP-180MC; L_12x12mm_H8mm; LCSC C2454078
L302: SCDS6D38T-220M-S-N; L_7.3x7.3_H4.5; LCSC C329694
Q301, Q302: CSD17571Q2; LCSC C962382
R301, R306, R309: 100K; R_0402_1005Metric; LCSC C25741
R302: 24K; R_0402_1005Metric; LCSC C25769
R303, R315: 4K7; R_0402_1005Metric; LCSC C25900
R304, R316: 10K; R_0402_1005Metric; LCSC C25744
R305: 8K66; R_0402_1005Metric; LCSC C11702
R307: 18K7; R_0402_1005Metric; LCSC C11476
R308, R313: 30mR 1%; R_0805_2012Metric; LCSC C247605
R310: 1K 1%; R_0402_1005Metric; LCSC C11702
R311, R312: 0R; R_0402_1005Metric; LCSC C17168
R314: 15K4 1%; R_0402_1005Metric; LCSC C62740
R317: 100; R_0402_1005Metric; LCSC C25076
R318: 3K24; R_0402_1005Metric; LCSC C162875
TP301: TestPoint; TestPoint_THTPad_D1.0mm_Drill0.5mm
U301: LM25118MH; HTSSOP-20-1EP_4.4x6.5mm_P0.65mm_EP2.74x3.86mm; LCSC C470962
U302: FUSB302BMPX; WQFN-14-1EP_2.5x2.5mm_P0.5mm_EP1.45x1.45mm
U303: TPS54332DDAR; SOIC-8-1EP_3.9x4.9mm_P1.27mm_EP2.29x3mm_ThermalVias; LCSC C41312

Connections:
12V_EN: R306.2, U301.4 (EN); also elsewhere on the board
12V_MEAS: C317.1, R309.1, R315.1; also elsewhere on the board
+3V3: C318.1, C319.1, C326.1, C327.1, C328.1, L302.2, R316.2, U302.3 (VDD), U302.4 (VDD); also elsewhere on the board
+12V: C312.1, C313.1, C314.1, C315.1, D302.1 (K), R305.2, R309.2, U301.10 (VOUT); also elsewhere on the board
/Power/3V3_BOOT: C323.2, U303.1 (BOOT)
/Power/3V3_COMP: C329.1, R317.2, U303.6 (COMP)
/Power/3V3_PH: C323.1, D303.1 (K), L302.1, U303.8 (PH)
/Power/3V3_SS: C331.1, U303.4 (SS)
/Power/3V3_VSENSE: R316.1, R318.2, U303.5 (VSENSE)
/Power/12V_COMP: C310.2, R314.1, U301.9 (COMP)
/Power/12V_CS: D301.2 (A), R313.2, U301.12 (CS)
/Power/12V_FB: C310.1, C311.1, R305.1, R310.2, U301.8 (FB)
/Power/12V_HB: C307.2, U301.18 (HB)
/Power/12V_HO: Q301.2 (G), U301.19 (HO)
/Power/12V_HS: C307.1, D301.1 (K), L301.1, Q301.3 (S), U301.20 (HS)
/Power/12V_LO: Q302.2 (G), U301.15 (LO)
/Power/12V_MI: D302.2 (A), L301.2, Q302.1 (D)
/Power/12V_RAMP: C309.1, U301.5 (RAMP)
/Power/12V_RT: R307.2, U301.3 (RT)
/Power/12V_SS: C308.1, U301.7 (SS)
/Power/12V_UVLO: R302.2, R304.2, U301.2 (UVLO)
/Power/12V_VCC: C302.1, U301.16 (VCC)
I2C_SCL: U302.6 (SCL); also elsewhere on the board
I2C_SDA: U302.7 (SDA); also elsewhere on the board
unnamed: C311.2, R314.2
unnamed: C330.1, R317.1
PD_INT_N: U302.5 (INT_N); also elsewhere on the board
USB_CC1: C324.1, U302.10 (CC1), U302.11 (CC1); also elsewhere on the board
USB_CC2: C325.1, U302.1 (CC2), U302.14 (CC2); also elsewhere on the board
VBUS: C301.1, C303.1, C304.1, C305.1, C320.1, C321.1, C322.1, Q301.1 (D), R301.2, R302.1, R308.1, R312.2, TP301.1, U301.1 (VIN), U303.2 (VIN)
VBUS_MEAS: C306.1, R301.1, R303.1; also elsewhere on the board
VBUS_MEAS_N: C316.2, R312.1; also elsewhere on the board
VBUS_MEAS_P: C316.1, R311.2; also elsewhere on the board
VUSB: R308.2, R311.1, U302.2 (VBUS); also elsewhere on the board

Notes on the sheet:
VBUS Voltage Sensing
RT = 18K7 -> 295kHz UVLO ~ 4.5V Current limit 1A
1MHz fixed No UVLO Rated current 0.5A
3V3 Buck Converter
VBUS max voltage ~ 16V ADC max voltage = 750mV 5V => 224mV 15V => 673mV
12V Buck/Boost Converter
USB Power Delivery Controller
VBUS Current Sensing
To op-amp on "Fans" page
5V to 20V input power Limited to 1A inductor current I.e. 5W to 20W 12V-15V for highest efficiency
12V Voltage Sensing
VBUS max voltage ~ 2V ADC max voltage = 750mV 12V => 539mV
Manage max current draw using MCU MCU, No 12V, No Radio => max 0.5W Increase USB PD mode for more current and higher efficiency Low-power device 100mA/5V/0.50W 5V PD SPR 3A/5V/15W (sufficient) 9V PD SPR 3A/9V/27W 15V PD SPR 3A/15V/45W (efficient) 20V PD SPR 3A/20V/60W
Power Test Points

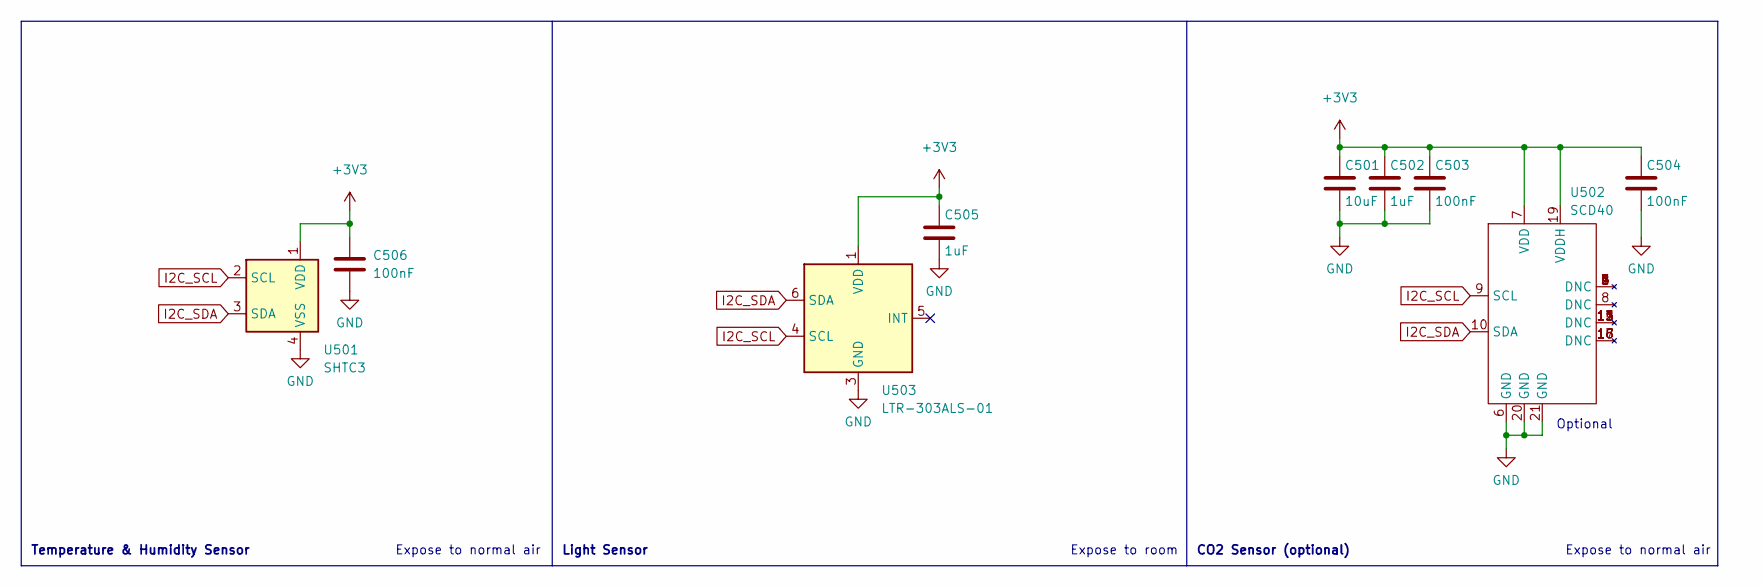
[picture p23: schematic sensors.kicad_sch, Fan Controller]

Parts:
C501: 10uF; C_0402_1005Metric; LCSC C15525
C502, C505: 1uF; C_0402_1005Metric; LCSC C52923
C503, C504, C506: 100nF; C_0402_1005Metric; LCSC C307331
U501: SHTC3; Sensirion_DFN-4-1EP_2x2mm_P1mm_EP0.7x1.6mm; LCSC C194656
U502: SCD40; SCD4x
U503: LTR-303ALS-01; Lite-On_LTR-303ALS-01; LCSC C364577

Connections:
+3V3: C501.1, C502.1, C503.1, C504.1, C505.1, C506.1, U501.1 (VDD), U502.7 (VDD), U502.19 (VDDH), U503.1 (VDD); also elsewhere on the board
I2C_SCL: U501.2 (SCL), U502.9 (SCL), U503.4 (SCL); also elsewhere on the board
I2C_SDA: U501.3 (SDA), U502.10 (SDA), U503.6 (SDA); also elsewhere on the board

Notes on the sheet:
Expose to room
Optional
Expose to normal air
Light Sensor
CO2 Sensor (optional)
Temperature & Humidity Sensor

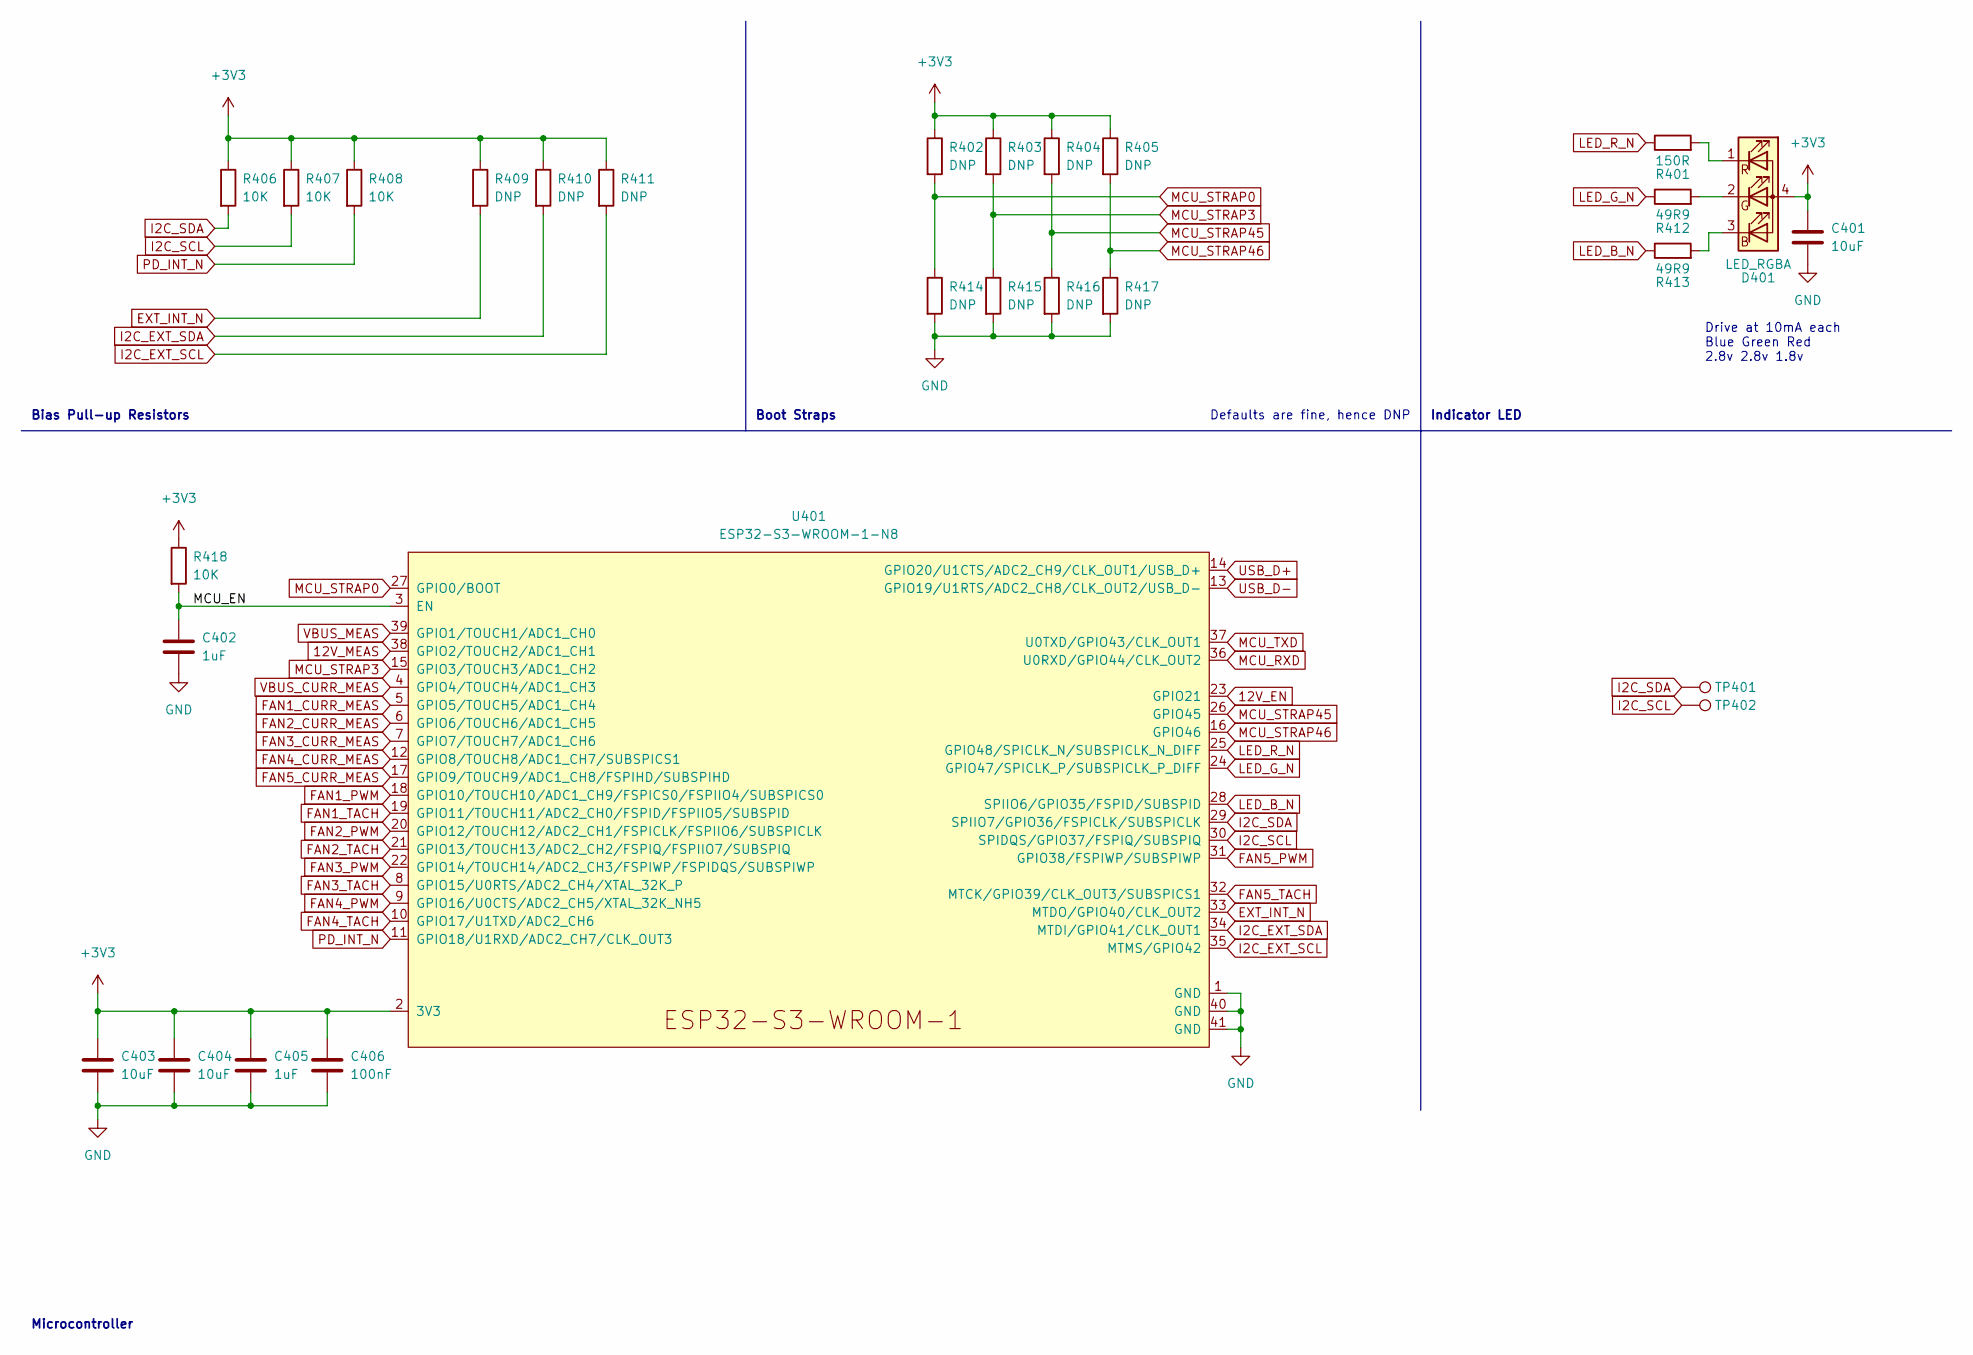
[picture p24: schematic mcu.kicad_sch]

Parts:
C401, C403, C404: 10uF; C_0402_1005Metric; LCSC C15525
C402, C405: 1uF; C_0402_1005Metric; LCSC C52923
C406: 100nF; C_0402_1005Metric; LCSC C307331
D401: LED_RGBA; LED_LiteOn_LTST-C19HE1WT; LCSC C427425
R401: 150R; R_0402_1005Metric; LCSC C25082
R402, R403, R404, R405, R409, R410, R411, R414, R415, R416, R417: DNP; R_0402_1005Metric
R406, R407, R408, R418: 10K; R_0402_1005Metric; LCSC C25744
R412, R413: 49R9; R_0402_1005Metric; LCSC C25120
TP401, TP402: TestPoint; TestPoint_THTPad_D1.0mm_Drill0.5mm
U401: ESP32-S3-WROOM-1-N8; ESP32-S3-WROOM-1; LCSC C2913198

Connections:
12V_EN: U401.23 (GPIO21); also elsewhere on the board
12V_MEAS: U401.38 (GPIO2/TOUCH2/ADC1_CH1); also elsewhere on the board
+3V3: C401.1, C403.1, C404.1, C405.1, C406.1, D401.4 (A), R402.1, R403.1, R404.1, R405.1, R406.1, R407.1, R408.1, R409.1, R410.1, R411.1, R418.1, U401.2 (3V3); also elsewhere on the board
/MCU/MCU_EN: C402.1, R418.2, U401.3 (EN)
EXT_INT_N: R409.2, U401.33 (MTDO/GPIO40/CLK_OUT2); also elsewhere on the board
FAN1_CURR_MEAS: U401.5 (GPIO5/TOUCH5/ADC1_CH4); also elsewhere on the board
FAN1_PWM: U401.18 (GPIO10/TOUCH10/ADC1_CH9/FSPICS0/FSPIIO4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); also elsewhere on the board
FAN1_TACH: U401.19 (GPIO11/TOUCH11/ADC2_CH0/FSPID/FSPIIO5/S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); also elsewhere on the board
FAN2_CURR_MEAS: U401.6 (GPIO6/TOUCH6/ADC1_CH5); also elsewhere on the board
FAN2_PWM: U401.20 (GPIO12/TOUCH12/ADC2_CH1/FSPICLK/FSPIIO6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); also elsewhere on the board
FAN2_TACH: U401.21 (GPIO13/TOUCH13/ADC2_CH2/FSPIQ/FSPIIO7/S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); also elsewhere on the board
FAN3_CURR_MEAS: U401.7 (GPIO7/TOUCH7/ADC1_CH6); also elsewhere on the board
FAN3_PWM: U401.22 (GPIO14/TOUCH14/ADC2_CH3/FSPIWP/FSPIDQS/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); also elsewhere on the board
FAN3_TACH: U401.8 (GPIO15/U0RTS/ADC2_CH4/XTAL_32K_P); also elsewhere on the board
FAN4_CURR_MEAS: U401.12 (GPIO8/TOUCH8/ADC1_CH7/SUBSPICS1); also elsewhere on the board
FAN4_PWM: U401.9 (GPIO16/U0CTS/ADC2_CH5/XTAL_32K_NH5); also elsewhere on the board
FAN4_TACH: U401.10 (GPIO17/U1TXD/ADC2_CH6); also elsewhere on the board
FAN5_CURR_MEAS: U401.17 (GPIO9/TOUCH9/ADC1_CH8/FSPIHD/SUBSPIHD); also elsewhere on the board
FAN5_PWM: U401.31 (GPIO38/FSPIWP/SUBSPIWP); also elsewhere on the board
FAN5_TACH: U401.32 (MTCK/GPIO39/CLK_OUT3/SUBSPICS1); also elsewhere on the board
I2C_EXT_SCL: R411.2, U401.35 (MTMS/GPIO42); also elsewhere on the board
I2C_EXT_SDA: R410.2, U401.34 (MTDI/GPIO41/CLK_OUT1); also elsewhere on the board
I2C_SCL: R407.2, TP402.1, U401.30 (SPIDQS/GPIO37/FSPIQ/SUBSPIQ); also elsewhere on the board
I2C_SDA: R406.2, TP401.1, U401.29 (SPIIO7/GPIO36/FSPICLK/SUBSPICLK); also elsewhere on the board
LED_B_N: R413.1, U401.28 (SPIIO6/GPIO35/FSPID/SUBSPID)
LED_G_N: R412.1, U401.24 (GPIO47/SPICLK_P/SUBSPICLK_P_DIFF)
LED_R_N: R401.1, U401.25 (GPIO48/SPICLK_N/SUBSPICLK_N_DIFF)
MCU_RXD: U401.36 (U0RXD/GPIO44/CLK_OUT2); also elsewhere on the board
MCU_STRAP0: R402.2, R414.1, U401.27 (GPIO0/BOOT)
MCU_STRAP3: R403.2, R415.1, U401.15 (GPIO3/TOUCH3/ADC1_CH2)
MCU_STRAP45: R404.2, R416.1, U401.26 (GPIO45)
MCU_STRAP46: R405.2, R417.1, U401.16 (GPIO46)
MCU_TXD: U401.37 (U0TXD/GPIO43/CLK_OUT1); also elsewhere on the board
unnamed: D401.1 (RK), R401.2
unnamed: D401.2 (GK), R412.2
unnamed: D401.3 (BK), R413.2
PD_INT_N: R408.2, U401.11 (GPIO18/U1RXD/ADC2_CH7/CLK_OUT3); also elsewhere on the board
USB_D+: U401.14 (GPIO20/U1CTS/ADC2_CH9/CLK_OUT1/USB_D+); also elsewhere on the board
USB_D-: U401.13 (GPIO19/U1RTS/ADC2_CH8/CLK_OUT2/USB_D-); also elsewhere on the board
VBUS_CURR_MEAS: U401.4 (GPIO4/TOUCH4/ADC1_CH3); also elsewhere on the board
VBUS_MEAS: U401.39 (GPIO1/TOUCH1/ADC1_CH0); also elsewhere on the board

Notes on the sheet:
Defaults are fine, hence DNP
Drive at 10mA each Blue Green Red 2.8v 2.8v 1.8v
Boot Straps
Indicator LED
Bias Pull-up Resistors
Microcontroller

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
