yorickvP/fancontroller/hw/1/fancontroller.kicad_pcb

## KiCad design hw/1/fancontroller.kicad_pcb (continued)

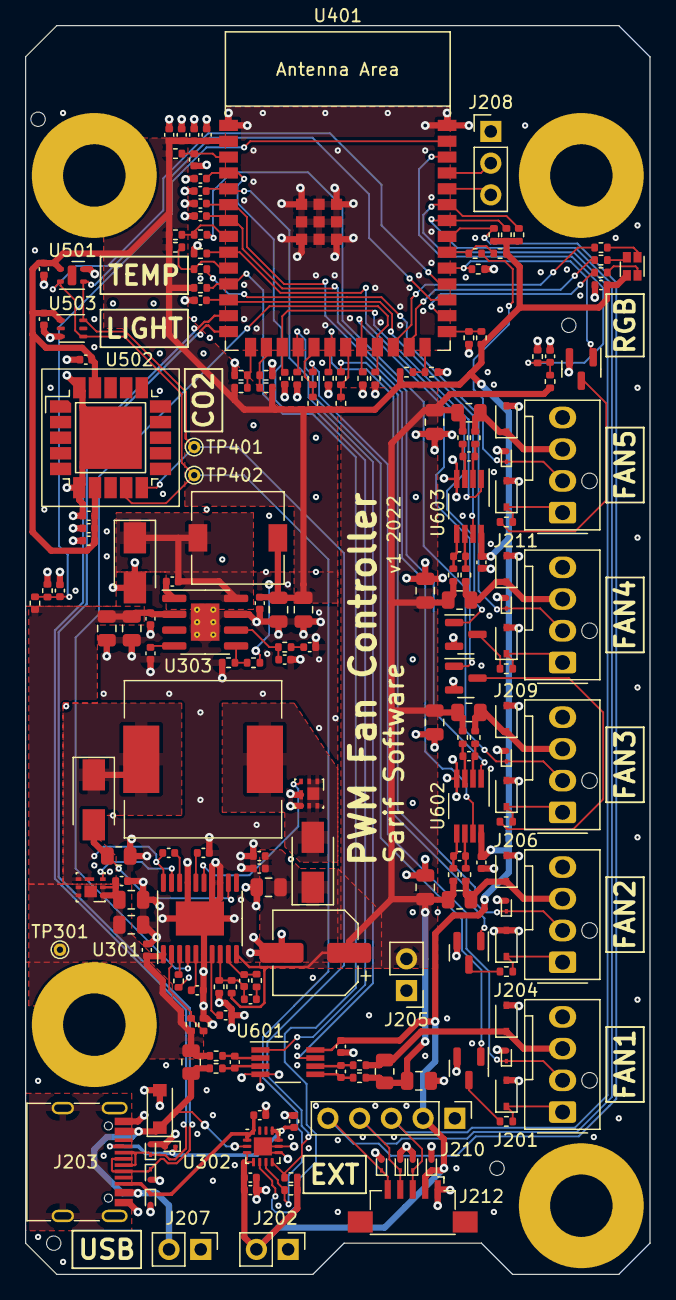
[picture p25: board fancontroller.kicad_pcb from above]

Board: 4 copper layers, 50.0 x 100.0 mm, 203 parts (0 on the bottom side), 99 nets.
