yorickvP/fancontroller/(commit log)

2023-11-10 Added revision 1 of hw
    [connectors.kicad_sch, fancontroller-sensor.kicad_pcb, fancontroller-sensor.kicad_sch, fancontroller.kicad_pcb, fancontroller.kicad_sch, fans.kicad_sch, mcu.kicad_sch, power.kicad_sch]
2023-11-10 Added rudimentary i2c bus locking
2023-11-13 Support newest ESP_IDF, added channels for temperature
2023-11-14 Revert data back to ESP-IDF v5.1.1
    [data.c]
2023-11-14 Added MQTT broker URL to KConfig
    [mqtt.c]
2023-11-14 Added rudimentary LED emotes
2023-11-14 Check for presence of external temperature sensor
2023-11-14 Do not emit empty object block if temperature measurement is invalid
2023-11-15 Disable LEDC channel if duty cycle is 0
